boardsource/open_keyboard_experiments/README.md

# Open Keyboard Experiments.

So as we design keyboards we at Boardsource try out a lot of things.
Most of these things never see the light of day.
Now instead of letting them rot on a hard drive I thought it would be cool to let others see what we were paying with and maybe take learning.
