boardsource/open_keyboard_experiments/smol/case/case_main_right.STL

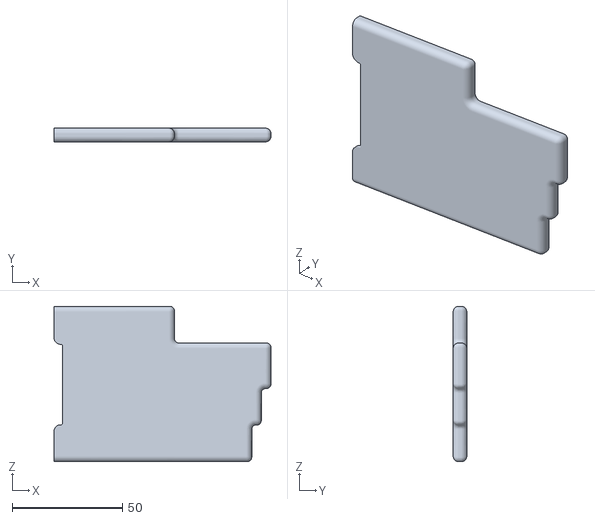
[picture p1: CAD file, 2023-03-31]
smol/case/case_main_right.STL
98.2 x 6.20 x 70.3
