boardsource/open_keyboard_experiments/smol/case/case_main.SLDPRT

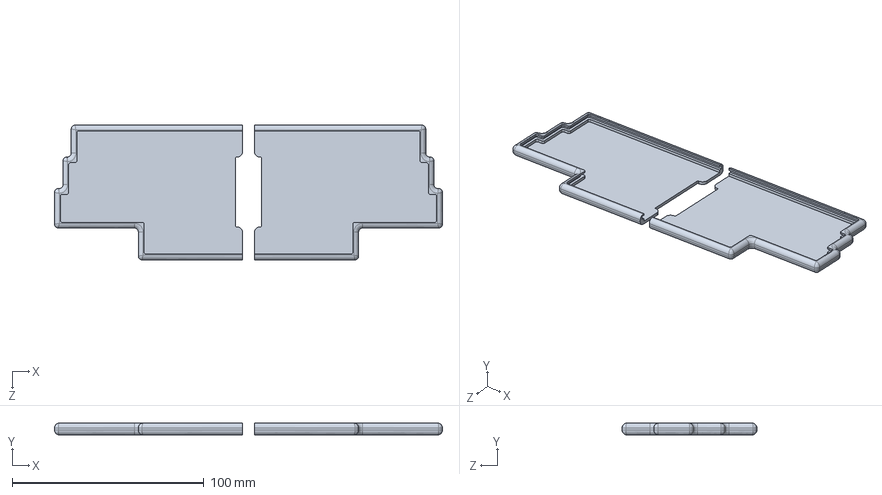
[picture p2: CAD file, 2023-03-31]
smol/case/case_main.SLDPRT
202.4 x 6.20 x 70.3 mm
