boardsource/open_keyboard_experiments/smol/case/case_both_pre_supported.stl

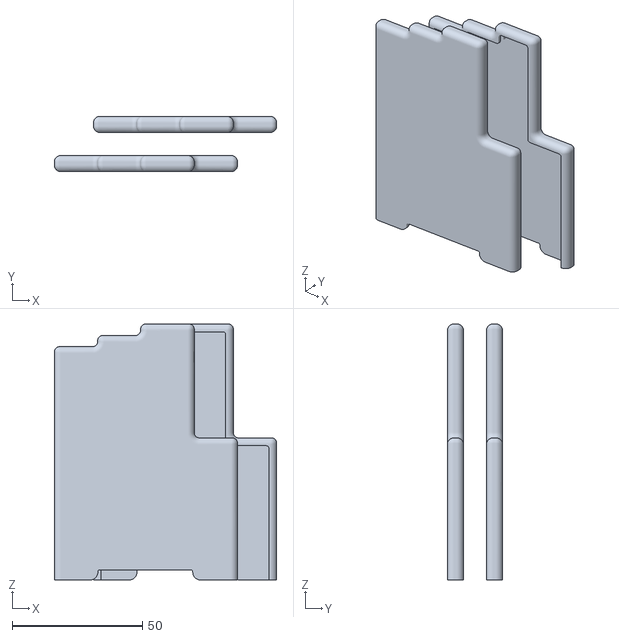
[picture p3: CAD file, 2023-03-31]
smol/case/case_both_pre_supported.stl
85.3 x 21.2 x 98.2
