boardsource/open_keyboard_experiments/(list of files, cad)

Other CAD files:
smol/case/case_main_left.STL
