boardsource/open_keyboard_experiments/smol/kicad/split-single.kicad_pcb

## KiCad design smol/kicad/split-single.kicad_pcb (2023-03-31)

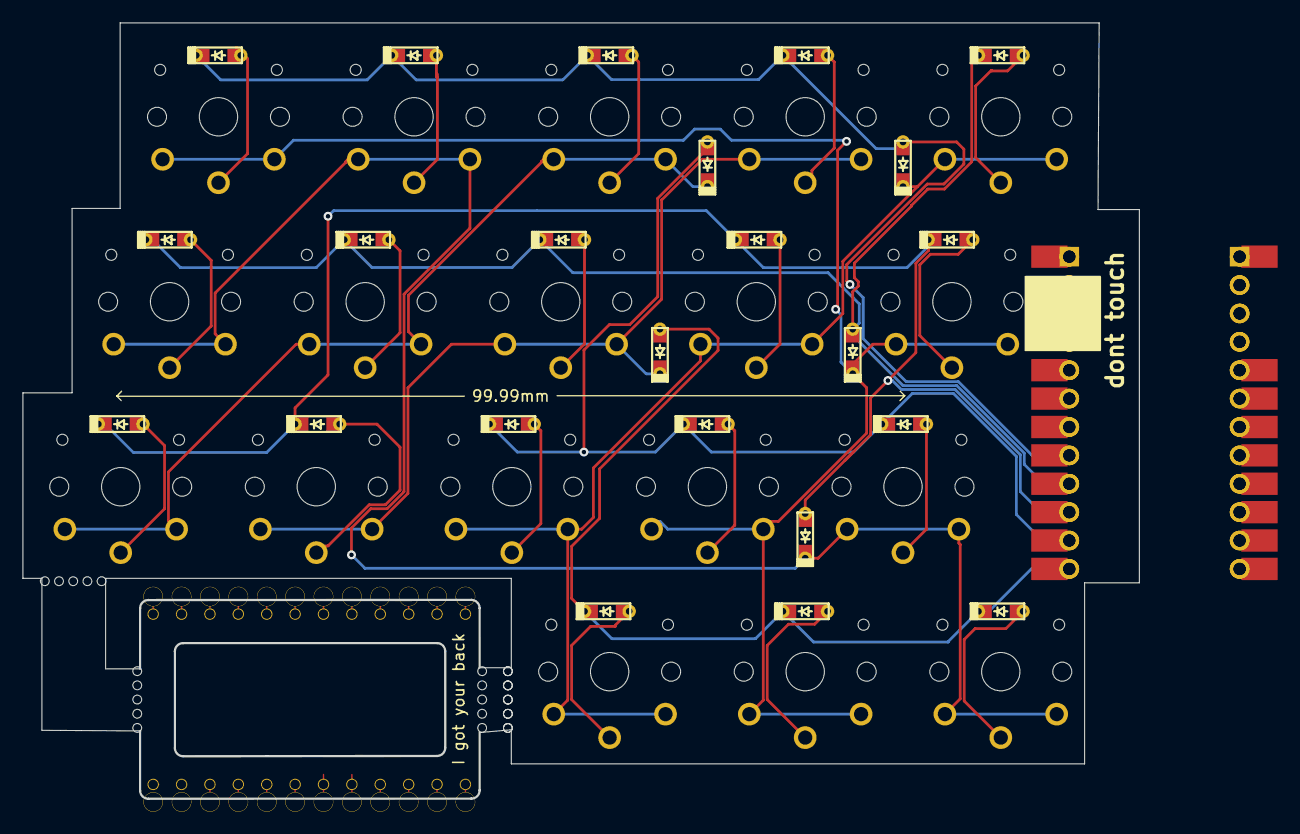
[picture p4: board split-single.kicad_pcb from above]

Board: 2 copper layers, 99.9 x 69.4 mm, 46 parts (1 on the bottom side), 50 nets.

Parts:
D1, D2, D3, D4, D5, D6, D7, D8, D9, D10, D11, D12, D13, D14, D15, D16, D17, D18, D19, D21, D22, D23, D25: D_Small; D_SOD123F_dual
FRAME2: FRAME-LEDGER; CREATIVE_COMMONS
J3, J4: CONN_12CASTLE; 1X12_CASTELLATED
SW1, SW2, SW3, SW4, SW5, SW6, SW7, SW8, SW9, SW10, SW11, SW12, SW13, SW14, SW15, SW17, SW18, SW19: SW_PUSH; SW_PG1350_reversible
U1, U2: ProMicro; Elite-C-castellated-24pin-holes

Connections:
3.3V: J4.4, J4.4B
/0/TX0: J3.12, J3.12B
/1/RX0: J3.11, J3.11B
/4: J3.6, J3.6B
/5: J3.5, J3.5B
/6: J3.4, J3.4B
/7: J3.3, J3.3B
/8/TX1: J3.2, J3.2B
/9/RX1: J3.1, J3.1B
/16/SDA: J3.8, J3.8B
/17/SCL: J3.7, J3.7B
/20/SPI_CIPO: J4.10, J4.10B
/21/SPI_~CS: J4.12, J4.12B
/22/SPI_SCK: J4.9, J4.9B
/23/SPI_COPI: J4.11, J4.11B
/A0: J4.8, J4.8B
/A1: J4.7, J4.7B
/A2: J4.6, J4.6B
/A3: J4.5, J4.5B
/RAW: J4.1, J4.1B
/~RESET: J4.3, J4.3B
GND: J3.9, J3.9B, J3.10, J3.10B, J4.2, J4.2B
unnamed: D1.1 (K), SW5.2, SW9.2, SW13.2, SW17.2
unnamed: D2.2 (A), SW1.1
unnamed: D3.2 (A), SW2.1
unnamed: D4.2 (A), SW3.1
unnamed: D5.2 (A), SW4.1
unnamed: D6.2 (A), SW5.1
unnamed: D7.1 (K), SW1.2, SW10.2, SW14.2, SW18.2
unnamed: D8.2 (A), SW6.1
unnamed: D9.2 (A), SW7.1
unnamed: D10.2 (A), SW8.1
unnamed: D11.2 (A), SW9.1
unnamed: D12.2 (A), SW10.1
unnamed: D13.1 (K), SW2.2, SW6.2, SW15.2, SW19.2
unnamed: D14.2 (A), SW11.1
unnamed: D15.2 (A), SW12.1
unnamed: D16.2 (A), SW13.1
unnamed: D17.2 (A), SW14.1
unnamed: D18.2 (A), SW15.1
unnamed: D19.1 (K), SW3.2, SW7.2, SW11.2
unnamed: D21.2 (A), SW17.1
unnamed: D22.2 (A), SW18.1
unnamed: D23.2 (A), SW19.1
unnamed: D25.1 (K), SW4.2, SW8.2, SW12.2
pin0: D1.2 (A), D2.1 (K), D3.1 (K), D4.1 (K), D5.1 (K), U1.8 (5/C6), U1.17 (F7/A0), U2.8 (5/C6), U2.17 (F7/A0)
pin1: D6.1 (K), D7.2 (A), D8.1 (K), D9.1 (K), D10.1 (K), U1.9 (6/D7), U1.16 (B1/15), U2.9 (6/D7), U2.16 (B1/15)
pin2: D11.1 (K), D12.1 (K), D13.2 (A), D14.1 (K), D15.1 (K), U1.10 (7/E6), U1.15 (B3/14), U2.10 (7/E6), U2.15 (B3/14)
pin3: D16.1 (K), D17.1 (K), D18.1 (K), D19.2 (A), U1.11 (8/B4), U1.14 (B2/16), U2.11 (8/B4), U2.14 (B2/16)
pin4: D21.1 (K), D22.1 (K), D23.1 (K), D25.2 (A), U1.12 (9/B5), U1.13 (B6/10), U2.12 (9/B5), U2.13 (B6/10)
