boardsource/open_keyboard_experiments/smol/buildguide.md

# Build Guide

Im lazy heres a bunch of pics.
Read the whole build guide before you start.
Your cheap keyboard is no longer cheap if you mess upo the controller.
If your diodes are backwards you may fry your controller.

everything you need

you only need:

- 1 [controller](https://boardsource.xyz/store/628b95b494dfa308a6581622)
- 36 [choc switches](https://boardsource.xyz/store/5fff705f03db380da20f1014) & [caps](https://boardsource.xyz/store/5f6ef2d68e3bf05ab838f918)
- 41 [diodes](https://boardsource.xyz/store/5ec9fc5d64caf04f83aa646c)
- 2 pcbs
- 2 cases

back support

So the 2 sides of the keyboard are held together with the controller.
this makes the keyboard very week the back support is there to offer well support to the keyboard this makes it just as strong as any other keyboard.

back support

snap off the back support included with the pcb

back support

jlc leaves it very messy just clean it up or not up to you.

diodes

This is the correct diode direction.
Black bar towards white bar on footprint.
If you dont know 30 second how to smd diode:

- solder one side
- hold diode with tweezers
- reflow pad
- push diode into liquid solder
- remove heat
- let go
- solder other side

diodes

All the diodes done for both sides.
Make sure of 3 things:

1. make sure you flip one pcb
2. you solder the extra diodes needed for square matrix
3. if you are using the 3d printed case from the repo, none of your diodes can be poking up they all need to be flat

https://i.imgur.com/AK6wQDB.jpeg

diodes

## Controller

controller supporter
install the pins from your controller into the back support.
the pins are needed for alinement only, you can solder them but the castellated pads are doing the work.

install the black bar on the out side of the keyboard through the back support through the pcb and into the controller.

https://i.imgur.com/2z98fv8.jpeg

controller supporter

controller

controller

push the whole thing down until its square and tack in one corner of the controller.
Do this for all corners, the controller needs to be sitting flat to use the solder pads.

controller

Once square solder all the bads making sure you flow down onto the pcb.

controller

trim the pins or remove them and do the same thing for the back

controller

controller

the sandwich

controller

## switches

install all your switches and solder them

switches

switches

# Case

you may need to clean up the mouse bites.
Then slide the case on from the out side in.

case

case

case

install your caps and enjoy.
