boardsource/open_keyboard_experiments/smol/firmware/words.py

from kmk.handlers.sequences import send_string

const=send_string("const ")
consolelog=send_string("console.log()")
arrowfunc=send_string("=()=>{}")
true=send_string("true")
false=send_string("false")

about=send_string('about ')
also=send_string('also ')
because=send_string('because ')
come=send_string('come ')
could=send_string('could ')
even=send_string('even ')
find=send_string('find ')
first=send_string('first ')
from_=send_string('from ')
give=send_string('give ')
have=send_string('have ')
here=send_string('here ')
into=send_string('into ')
just=send_string('just ')
know=send_string('know ')
like=send_string('like ')
look=send_string('look ')
make=send_string('make ')
many=send_string('many ')
more=send_string('more ')
only=send_string('only ')
other=send_string('other ')
people=send_string('people ')
some=send_string('some ')
take=send_string('take ')
tell=send_string('tell ')
than=send_string('than ')
that=send_string('that ')
their=send_string('their ')
them=send_string('them ')
then=send_string('then ')
there=send_string('there ')
these=send_string('these ')
they=send_string('they ')
thing=send_string('thing ')
think=send_string('think ')
this=send_string('this ')
those=send_string('those ')
time=send_string('time ')
very=send_string('very ')
want=send_string('want ')
well=send_string('well ')
what=send_string('what ')
when=send_string('when ')
which=send_string('which ')
will=send_string('will ')
with_=send_string('with ')
would=send_string('would ')
year=send_string('year ')
your=send_string('your ')
