boardsource/open_keyboard_experiments/(commit log)

2023-03-31 smol keyboard
    [split-single-B_Mask.gbr, split-single-B_Paste.gbr, split-single-B_Silkscreen.gbr, split-single-Bottom.gbr, split-single-Edge_Cuts.gbr, split-single-F_Mask.gbr, split-single-F_Paste.gbr, split-single-F_Silkscreen.gbr]
2023-03-31 added case
    [case_both_pre_supported.stl, case_main.SLDPRT, case_main_left.STL, case_main_right.STL]
2023-03-31 gerber note
